ifilot/morseboard-8088/enclosure/morseboard-8088-enclosure.stl

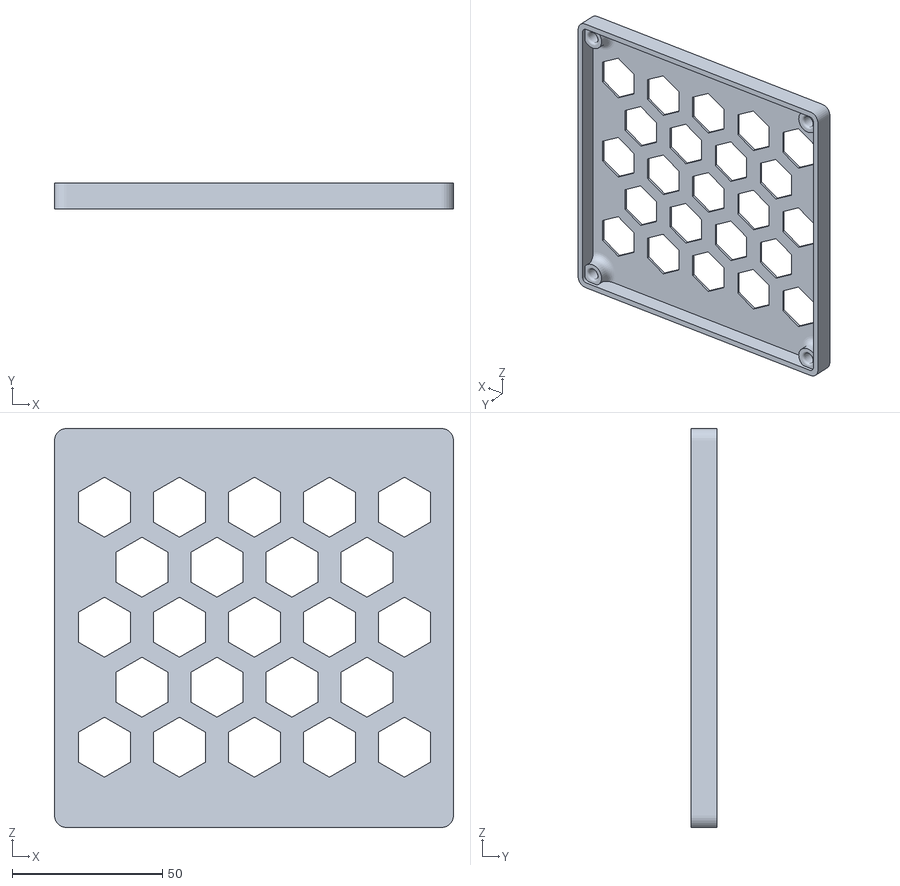
[picture p1: CAD file, 2025-07-02]
enclosure/morseboard-8088-enclosure.stl
133.0 x 8.51 x 133.0
