ifilot/morseboard-8088/pcb/components/USB type-B female PCB.STEP

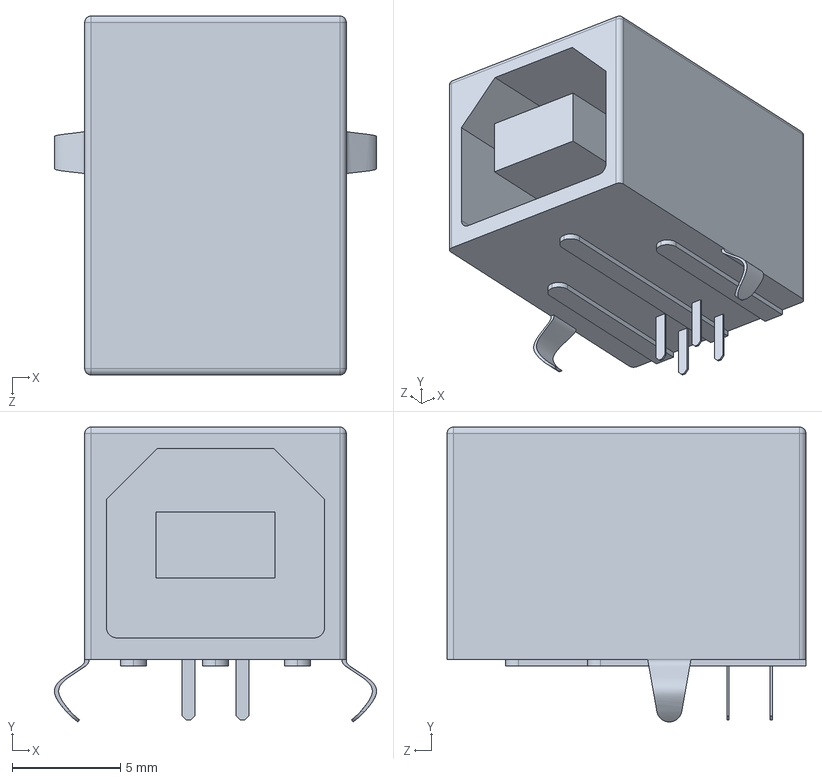
[picture p2: CAD file, 2025-07-06]
pcb/components/USB type-B female PCB.STEP
14.9 x 13.6 x 16.6 mm
