ifilot/morseboard-8088/pcb/components/PLCC44.STEP

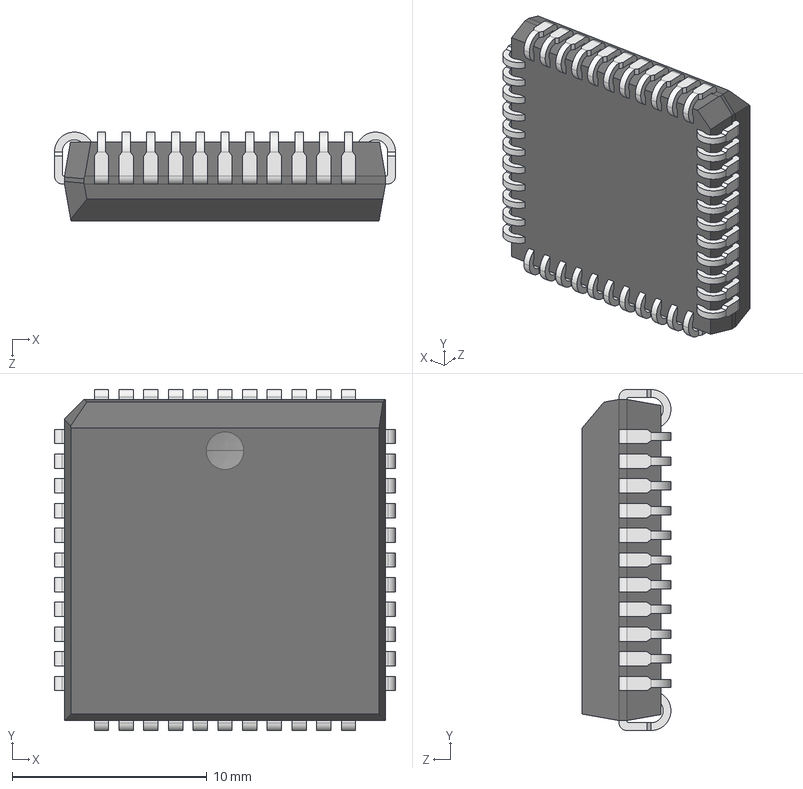
[picture p3: CAD file, 2025-07-06]
pcb/components/PLCC44.STEP
17.5 x 17.5 x 4.57 mm
