ifilot/morseboard-8088/pcb/components/PLCC44_socket.stp

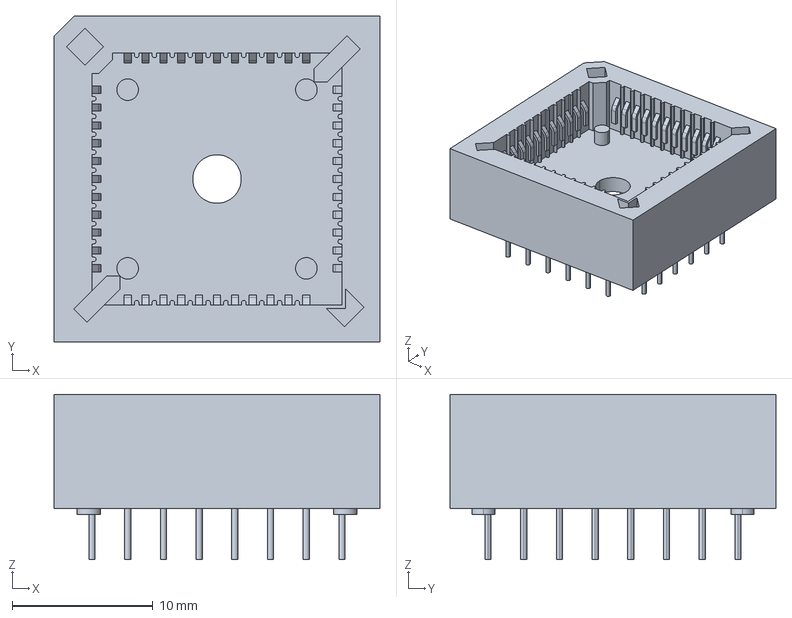
[picture p4: CAD file, 2025-07-06]
pcb/components/PLCC44_socket.stp
23.2 x 23.2 x 11.8 mm
