ifilot/morseboard-8088/pcb/components/switch.stp

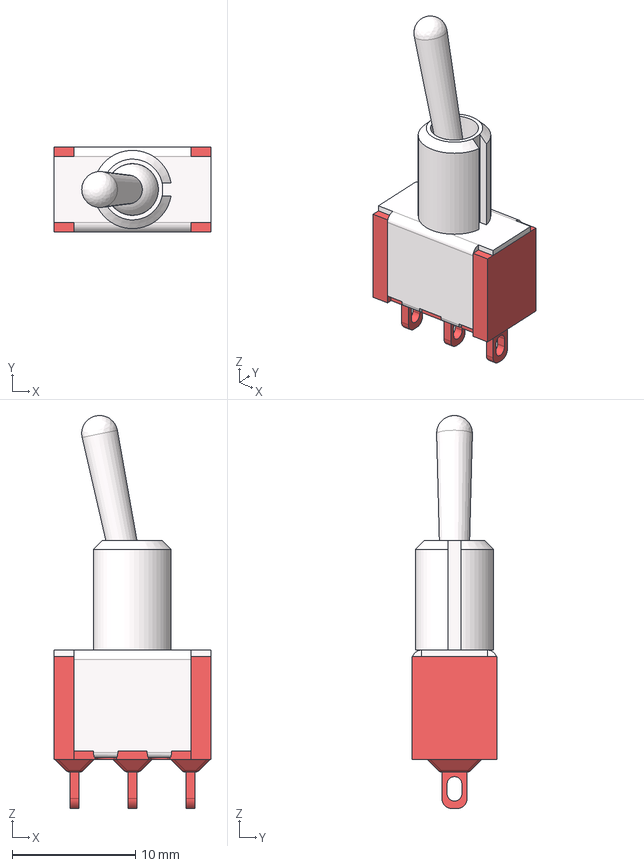
[picture p5: CAD file, 2025-07-06]
pcb/components/switch.stp
12.7 x 6.86 x 31.9 mm
100-300SPXBODY
100SPXBRACKET
100T1
100B1BUSHING
100-300SPXM1
