ifilot/morseboard-8088/(list of files, drawings)

Other design files:
pcb/cpu-testboard/mb88-testboard.dsn
pcb/morseboard-8088/morseboard-8088.dsn
