ifilot/morseboard-8088/pcb/morseboard-8088/morseboard-8088.kicad_pcb

## KiCad design pcb/morseboard-8088/morseboard-8088.kicad_pcb (2025-07-06)

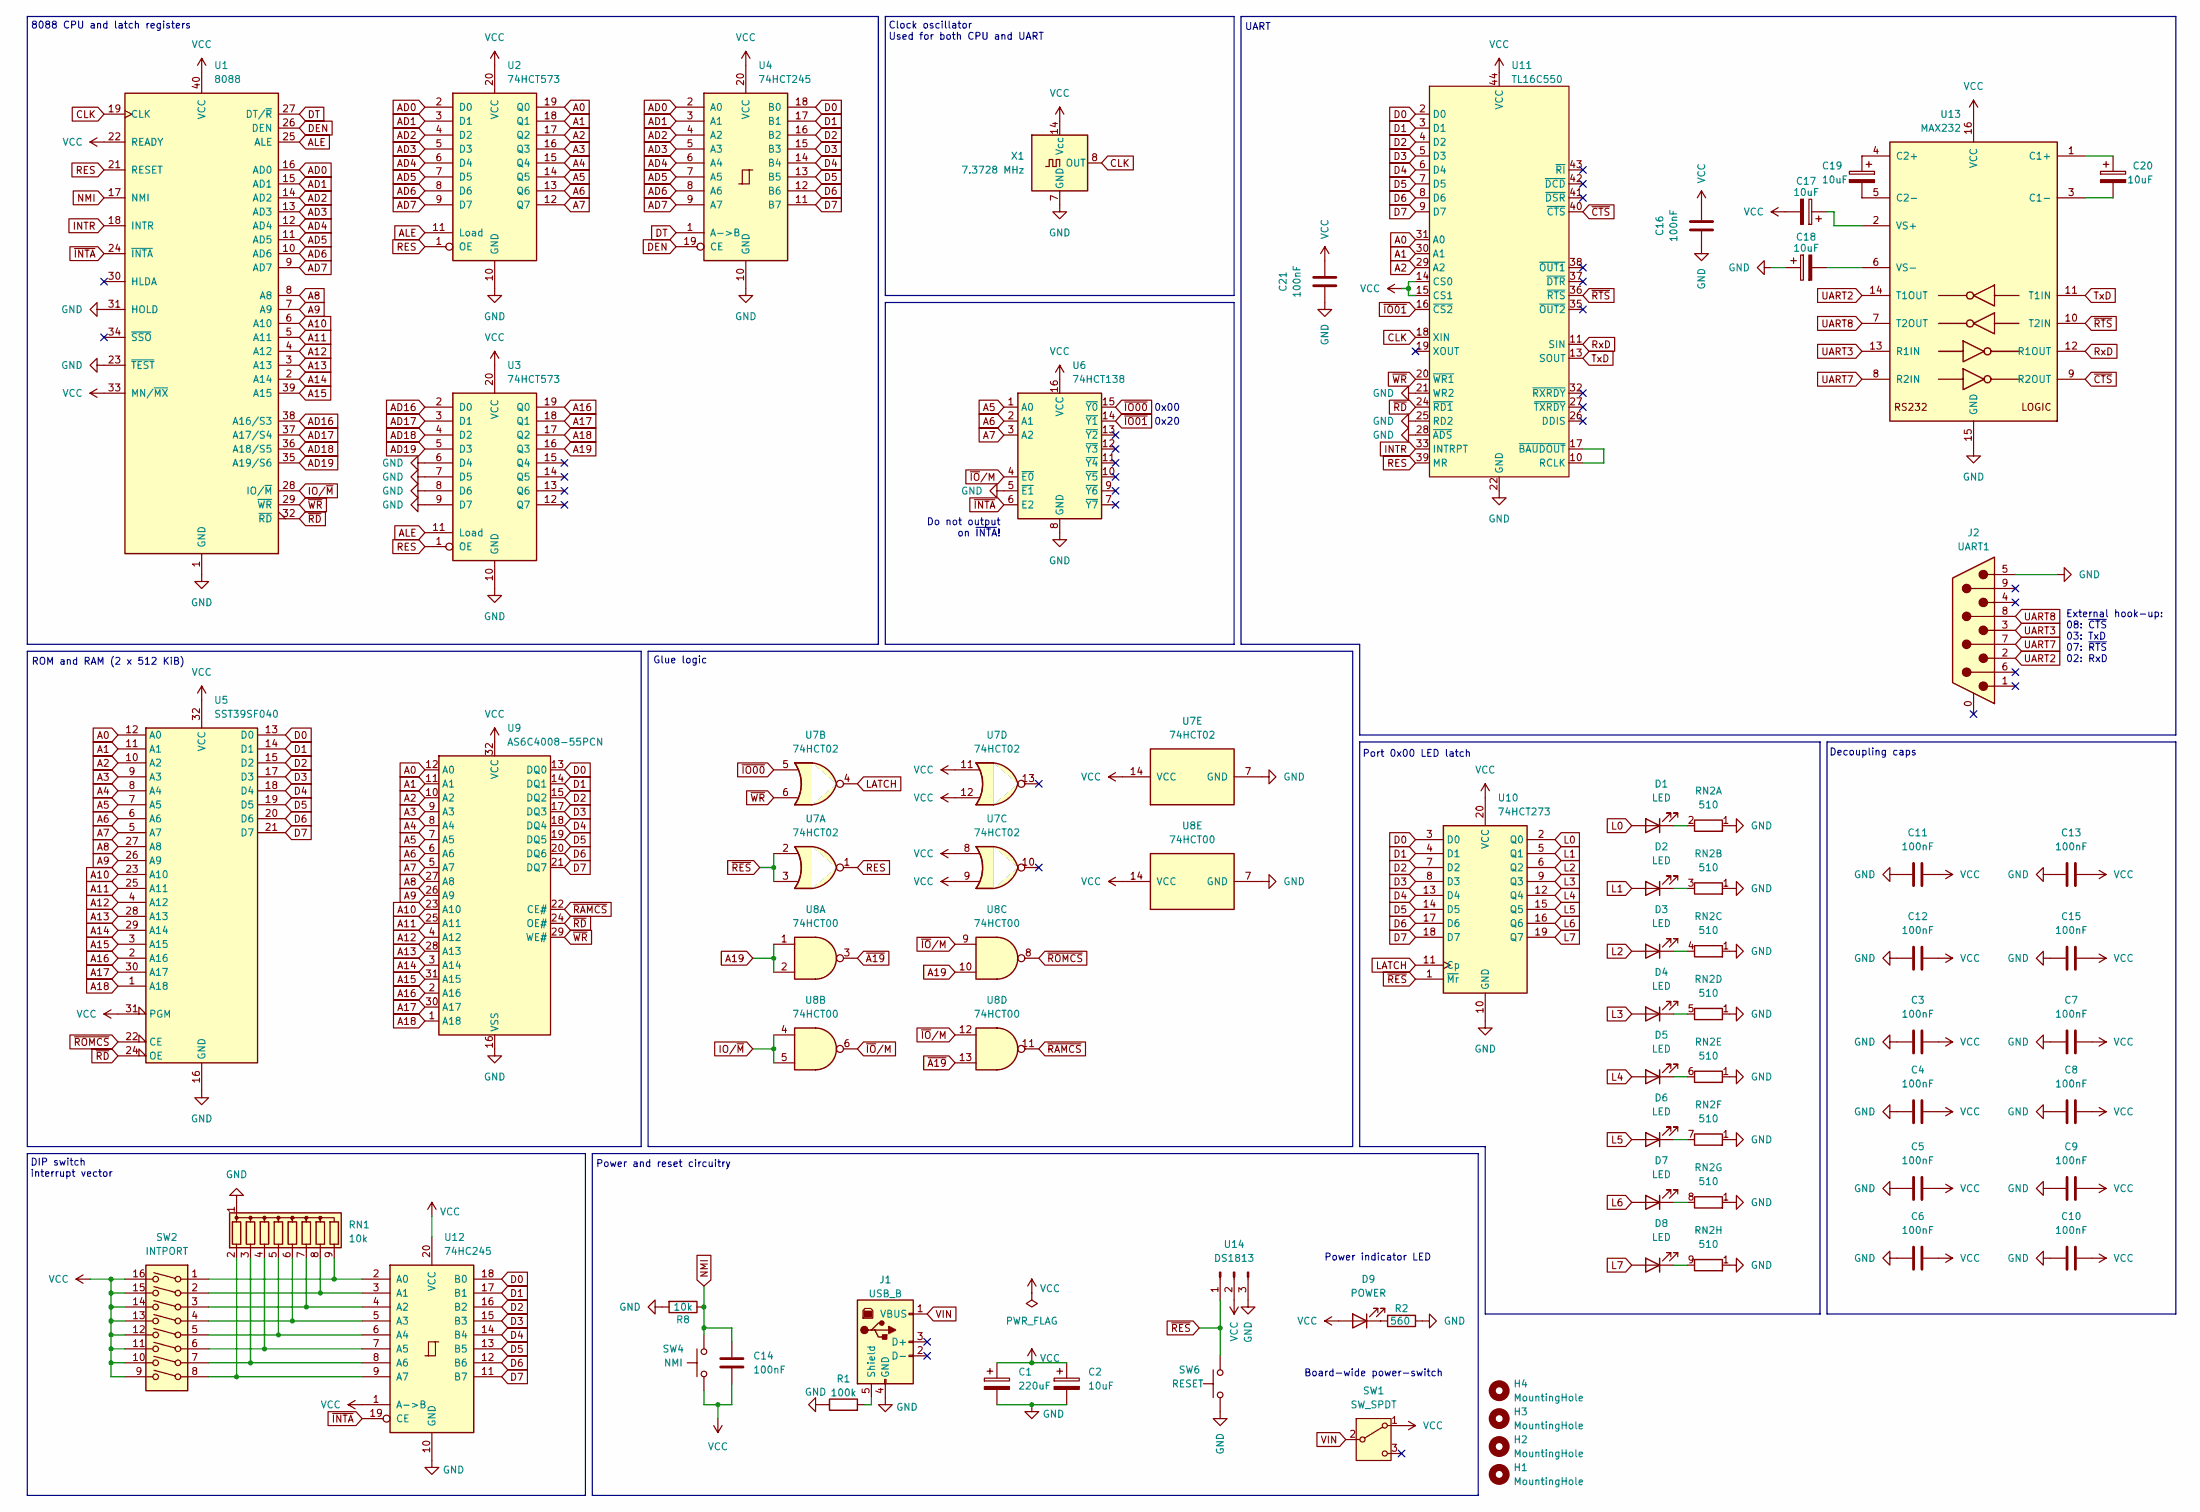
[picture p6: schematic morseboard-8088.kicad_sch]

Parts:
C1: 220uF; CP_Radial_D6.3mm_P2.50mm
C2, C17, C18, C19, C20: 10uF; CP_Radial_D5.0mm_P2.50mm
C3, C4, C5, C6, C7, C8, C9, C10, C11, C12, C13, C14, C15, C16, C21: 100nF; C_Disc_D5.0mm_W2.5mm_P5.00mm
D1, D2, D3, D4, D5, D6, D7, D8: LED; LED_D5.0mm
D9: POWER; LED_D5.0mm
H1, H2, H3, H4: MountingHole; MountingHole_3.2mm_M3_DIN965
J1: USB_B; USB_B_OST_USB-B1HSxx_Horizontal
J2: UART1; DSUB-9_Pins_Horizontal_P2.77x2.84mm_EdgePinOffset4.94mm_Hou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
R1: 100k; R_Axial_DIN0207_L6.3mm_D2.5mm_P7.62mm_Horizontal
R2: 560; R_Axial_DIN0207_L6.3mm_D2.5mm_P7.62mm_Horizontal
R8: 10k; R_Axial_DIN0207_L6.3mm_D2.5mm_P7.62mm_Horizontal
RN1: 10k; R_Array_SIP9
RN2: 510; R_Array_SIP9
SW1: SW_SPDT; power_switch
SW2: INTPORT; SW_DIP_SPSTx08_Slide_9.78x22.5mm_W7.62mm_P2.54mm
SW4: NMI; SW_PUSH_6mm
SW6: RESET; SW_PUSH_6mm
U1: 8088; DIP-40_W15.24mm_Socket
U2, U3: 74HCT573; DIP-20_W7.62mm_Socket
U4: 74HCT245; DIP-20_W7.62mm_Socket
U5: SST39SF040; DIP_Socket-32_W11.9_W12.7_W15.24_W17.78_W18.5_3M_232-1285-0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
U6: 74HCT138; DIP-16_W7.62mm_Socket
U7: 74HCT02; DIP-14_W7.62mm_Socket
U8: 74HCT00; DIP-14_W7.62mm_Socket
U9: AS6C4008-55PCN; DIP-32_W15.24mm_Socket
U10: 74HCT273; DIP-20_W7.62mm_Socket
U11: TL16C550; PLCC-44_THT-Socket
U12: 74HC245; DIP-20_W7.62mm_Socket
U13: MAX232; DIP-16_W7.62mm_Socket
U14: DS1813; TO-92
X1: 7.3728 MHz; Oscillator_DIP-14

Connections:
A0: U2.19 (Q0), U5.12 (A0), U9.12 (A0), U11.31 (A0)
A1: U2.18 (Q1), U5.11 (A1), U9.11 (A1), U11.30 (A1)
A2: U2.17 (Q2), U5.10 (A2), U9.10 (A2), U11.29 (A2)
A3: U2.16 (Q3), U5.9 (A3), U9.9 (A3)
A4: U2.15 (Q4), U5.8 (A4), U9.8 (A4)
A5: U2.14 (Q5), U5.7 (A5), U6.1 (A0), U9.7 (A5)
A6: U2.13 (Q6), U5.6 (A6), U6.2 (A1), U9.6 (A6)
A7: U2.12 (Q7), U5.5 (A7), U6.3 (A2), U9.5 (A7)
A8: U1.8 (A8), U5.27 (A8), U9.27 (A8)
A9: U1.7 (A9), U5.26 (A9), U9.26 (A9)
A10: U1.6 (A10), U5.23 (A10), U9.23 (A10)
A11: U1.5 (A11), U5.25 (A11), U9.25 (A11)
A12: U1.4 (A12), U5.4 (A12), U9.4 (A12)
A13: U1.3 (A13), U5.28 (A13), U9.28 (A13)
A14: U1.2 (A14), U5.29 (A14), U9.3 (A14)
A15: U1.39 (A15), U5.3 (A15), U9.31 (A15)
A16: U3.19 (Q0), U5.2 (A16), U9.2 (A16)
A17: U3.18 (Q1), U5.30 (A17), U9.30 (A17)
A18: U3.17 (Q2), U5.1 (A18), U9.1 (A18)
A19: U3.16 (Q3), U8.1, U8.2, U8.10
AD0: U1.16 (AD0), U2.2 (D0), U4.2 (A0)
AD1: U1.15 (AD1), U2.3 (D1), U4.3 (A1)
AD2: U1.14 (AD2), U2.4 (D2), U4.4 (A2)
AD3: U1.13 (AD3), U2.5 (D3), U4.5 (A3)
AD4: U1.12 (AD4), U2.6 (D4), U4.6 (A4)
AD5: U1.11 (AD5), U2.7 (D5), U4.7 (A5)
AD6: U1.10 (AD6), U2.8 (D6), U4.8 (A6)
AD7: U1.9 (AD7), U2.9 (D7), U4.9 (A7)
AD16: U1.38 (A16/S3), U3.2 (D0)
AD17: U1.37 (A17/S4), U3.3 (D1)
AD18: U1.36 (A18/S5), U3.4 (D2)
AD19: U1.35 (A19/S6), U3.5 (D3)
ALE: U1.25 (ALE), U2.11 (Load), U3.11 (Load)
CLK: U1.19 (CLK), U11.18 (XIN), X1.8 (OUT)
D0: U4.18 (B0), U5.13 (D0), U9.13 (DQ0), U10.3 (D0), U11.2 (D0), U12.18 (B0)
D1: U4.17 (B1), U5.14 (D1), U9.14 (DQ1), U10.4 (D1), U11.3 (D1), U12.17 (B1)
D2: U4.16 (B2), U5.15 (D2), U9.15 (DQ2), U10.7 (D2), U11.4 (D2), U12.16 (B2)
D3: U4.15 (B3), U5.17 (D3), U9.17 (DQ3), U10.8 (D3), U11.5 (D3), U12.15 (B3)
D4: U4.14 (B4), U5.18 (D4), U9.18 (DQ4), U10.13 (D4), U11.6 (D4), U12.14 (B4)
D5: U4.13 (B5), U5.19 (D5), U9.19 (DQ5), U10.14 (D5), U11.7 (D5), U12.13 (B5)
D6: U4.12 (B6), U5.20 (D6), U9.20 (DQ6), U10.17 (D6), U11.8 (D6), U12.12 (B6)
D7: U4.11 (B7), U5.21 (D7), U9.21 (DQ7), U10.18 (D7), U11.9 (D7), U12.11 (B7)
DEN: U1.26 (DEN), U4.19 (CE)
DT: U1.27 (DT/~R), U4.1 (A->B)
GND: C1.2, C2.2, C3.2, C4.2, C5.2, C6.2, C7.2, C8.2, C9.2, C10.2, C11.2, C12.2, C13.2, C15.2, C16.2, C18.1, C21.2, J1.4 (GND), J2.5, R1.1, R2.1, R8.2, RN1.1 (common), RN2.1 (R1), SW6.1, U1.1 (GND), U1.20 (GND), U1.23 (~TEST), U1.31 (HOLD), U2.10 (GND), U3.6 (D4), U3.7 (D5), U3.8 (D6), U3.9 (D7), U3.10 (GND), U4.10 (GND), U5.16 (GND), U6.5 (~E1), U6.8 (GND), U7.7 (GND), U8.7 (GND), U9.16 (VSS), U10.10 (GND), U11.21 (WR2), U11.22 (GND), U11.25 (RD2), U11.28 (~ADS), U12.10 (GND), U13.15 (GND), U14.3, X1.7 (GND)
INTR: U1.18 (INTR), U11.33 (INTRPT)
IO/~M: U1.28 (IO/~M), U8.4, U8.5
L0: D1.2 (A), U10.2 (Q0)
L1: D2.2 (A), U10.5 (Q1)
L2: D3.2 (A), U10.6 (Q2)
L3: D4.2 (A), U10.9 (Q3)
L4: D5.2 (A), U10.12 (Q4)
L5: D6.2 (A), U10.15 (Q5)
L6: D7.2 (A), U10.16 (Q6)
L7: D8.2 (A), U10.19 (Q7)
LATCH: U7.4, U10.11 (Cp)
NMI: C14.1, R8.1, SW4.2, U1.17 (NMI)
unnamed: D1.1 (K), RN2.2 (R1.2)
unnamed: D2.1 (K), RN2.3 (R2.2)
unnamed: D3.1 (K), RN2.4 (R3.2)
unnamed: D4.1 (K), RN2.5 (R4.2)
unnamed: D5.1 (K), RN2.6 (R5.2)
unnamed: D6.1 (K), RN2.7 (R6.2)
unnamed: D7.1 (K), RN2.8 (R7.2)
unnamed: D8.1 (K), RN2.9 (R8.2)
unnamed: D9.1 (K), R2.2
unnamed: J1.5 (Shield), R1.2
unnamed: RN1.2 (R1), SW2.8, U12.9 (A7)
unnamed: RN1.3 (R2), SW2.7, U12.8 (A6)
unnamed: RN1.4 (R3), SW2.6, U12.7 (A5)
unnamed: RN1.5 (R4), SW2.5, U12.6 (A4)
unnamed: RN1.6 (R5), SW2.4, U12.5 (A3)
unnamed: RN1.7 (R6), SW2.3, U12.4 (A2)
unnamed: RN1.8 (R7), SW2.2, U12.3 (A1)
unnamed: RN1.9 (R8), SW2.1, U12.2 (A0)
unnamed: U11.10 (RCLK), U11.17 (~BAUDOUT)
unnamed: C20.1, U13.1 (C1+)
unnamed: C20.2, U13.3 (C1-)
unnamed: C19.1, U13.4 (C2+)
unnamed: C19.2, U13.5 (C2-)
unnamed: C17.1, U13.2 (VS+)
unnamed: C18.2, U13.6 (VS-)
RES: U1.21 (RESET), U2.1 (OE), U3.1 (OE), U7.1, U11.39 (MR)
RxD: U11.11 (SIN), U13.12 (R1OUT)
TxD: U11.13 (SOUT), U13.11 (T1IN)
UART2: J2.2, U13.14 (T1OUT)
UART3: J2.3, U13.13 (R1IN)
UART7: J2.7, U13.8 (R2IN)
UART8: J2.8, U13.7 (T2OUT)
VCC: C1.1, C2.1, C3.1, C4.1, C5.1, C6.1, C7.1, C8.1, C9.1, C10.1, C11.1, C12.1, C13.1, C14.2, C15.1, C16.1, C17.2, C21.1, D9.2 (A), SW1.1 (A), SW2.9, SW2.10, SW2.11, SW2.12, SW2.13, SW2.14, SW2.15, SW2.16, SW4.1, U1.22 (READY), U1.33 (MN/~MX), U1.40 (VCC), U2.20 (VCC), U3.20 (VCC), U4.20 (VCC), U5.31 (PGM), U5.32 (VCC), U6.16 (VCC), U7.8, U7.9, U7.11, U7.12, U7.14 (VCC), U8.14 (VCC), U9.32 (VCC), U10.20 (VCC), U11.14 (CS0), U11.15 (CS1), U11.44 (VCC), U12.1 (A->B), U12.20 (VCC), U13.16 (VCC), U14.2, X1.14 (Vcc)
VIN: J1.1 (VBUS), SW1.2 (B)
~A19: U8.3, U8.13
~CTS: U11.40 (~CTS), U13.9 (R2OUT)
~INTA: U1.24 (~INTA), U6.6 (E2), U12.19 (CE)
~IO00: U6.15 (~Y0), U7.5
~IO01: U6.14 (~Y1), U11.16 (~CS2)
~IO/M: U6.4 (~E0), U8.6, U8.9, U8.12
~RAMCS: U8.11, U9.22 (CE#)
~RD: U1.32 (~RD), U5.24 (OE), U9.24 (OE#), U11.24 (~RD1)
~RES: SW6.2, U7.2, U7.3, U10.1 (~Mr), U14.1
~ROMCS: U5.22 (CE), U8.8
~RTS: U11.36 (~RTS), U13.10 (T2IN)
~WR: U1.29 (~WR), U7.6, U9.29 (WE#), U11.20 (~WR1)

Notes on the sheet:
Decoupling caps
0x20
Port 0x00 LED latch
Board-wide power-switch
8088 CPU and latch registers
Power and reset circuitry
Do not output on ~{INTA}!
UART
Power indicator LED
Glue logic
0x00
ROM and RAM (2 x 512 KiB)
External hook-up: 08: ~{CTS} 03: TxD 07: ~{RTS} 02: RxD
Clock oscillator Used for both CPU and UART
DIP switch interrupt vector

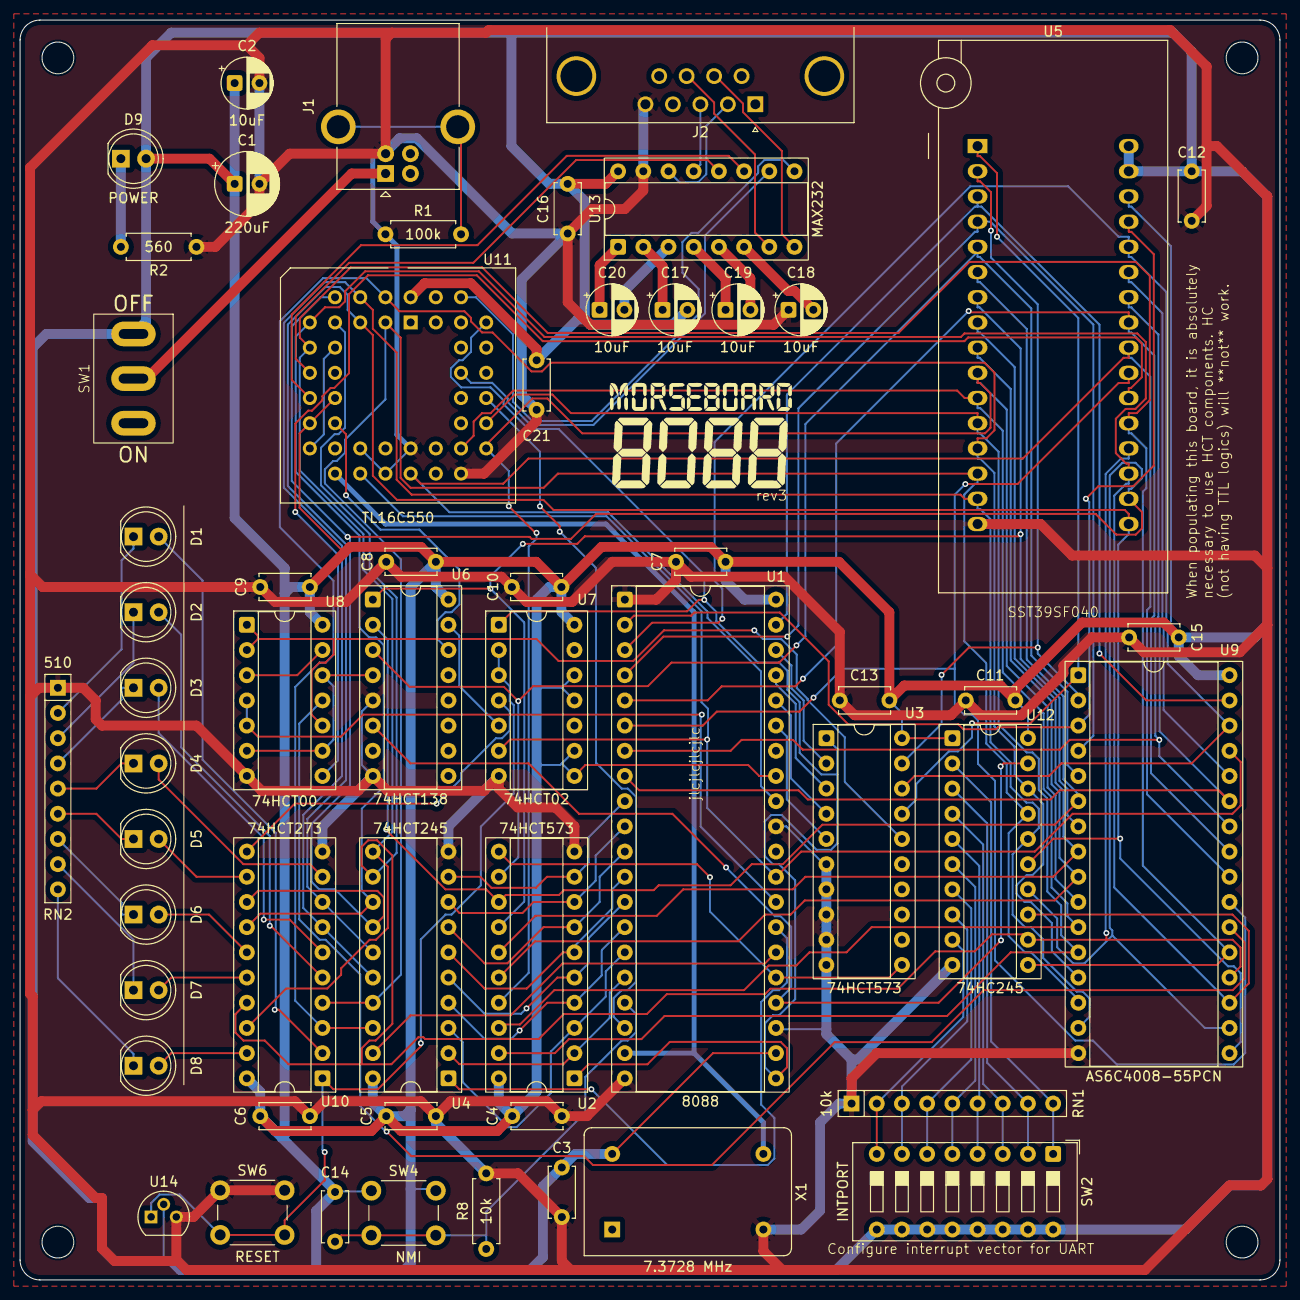
[picture p7: board morseboard-8088.kicad_pcb from above]

Board: 2 copper layers, 127.0 x 127.0 mm, 61 parts (0 on the bottom side), 103 nets.

Other parts of the board:
G001: LOGO; morseboard-logo-12h
