ifilot/morseboard-8088/pcb/cpu-testboard/mb88-testboard.kicad_pcb

## KiCad design pcb/cpu-testboard/mb88-testboard.kicad_pcb (2025-05-21)

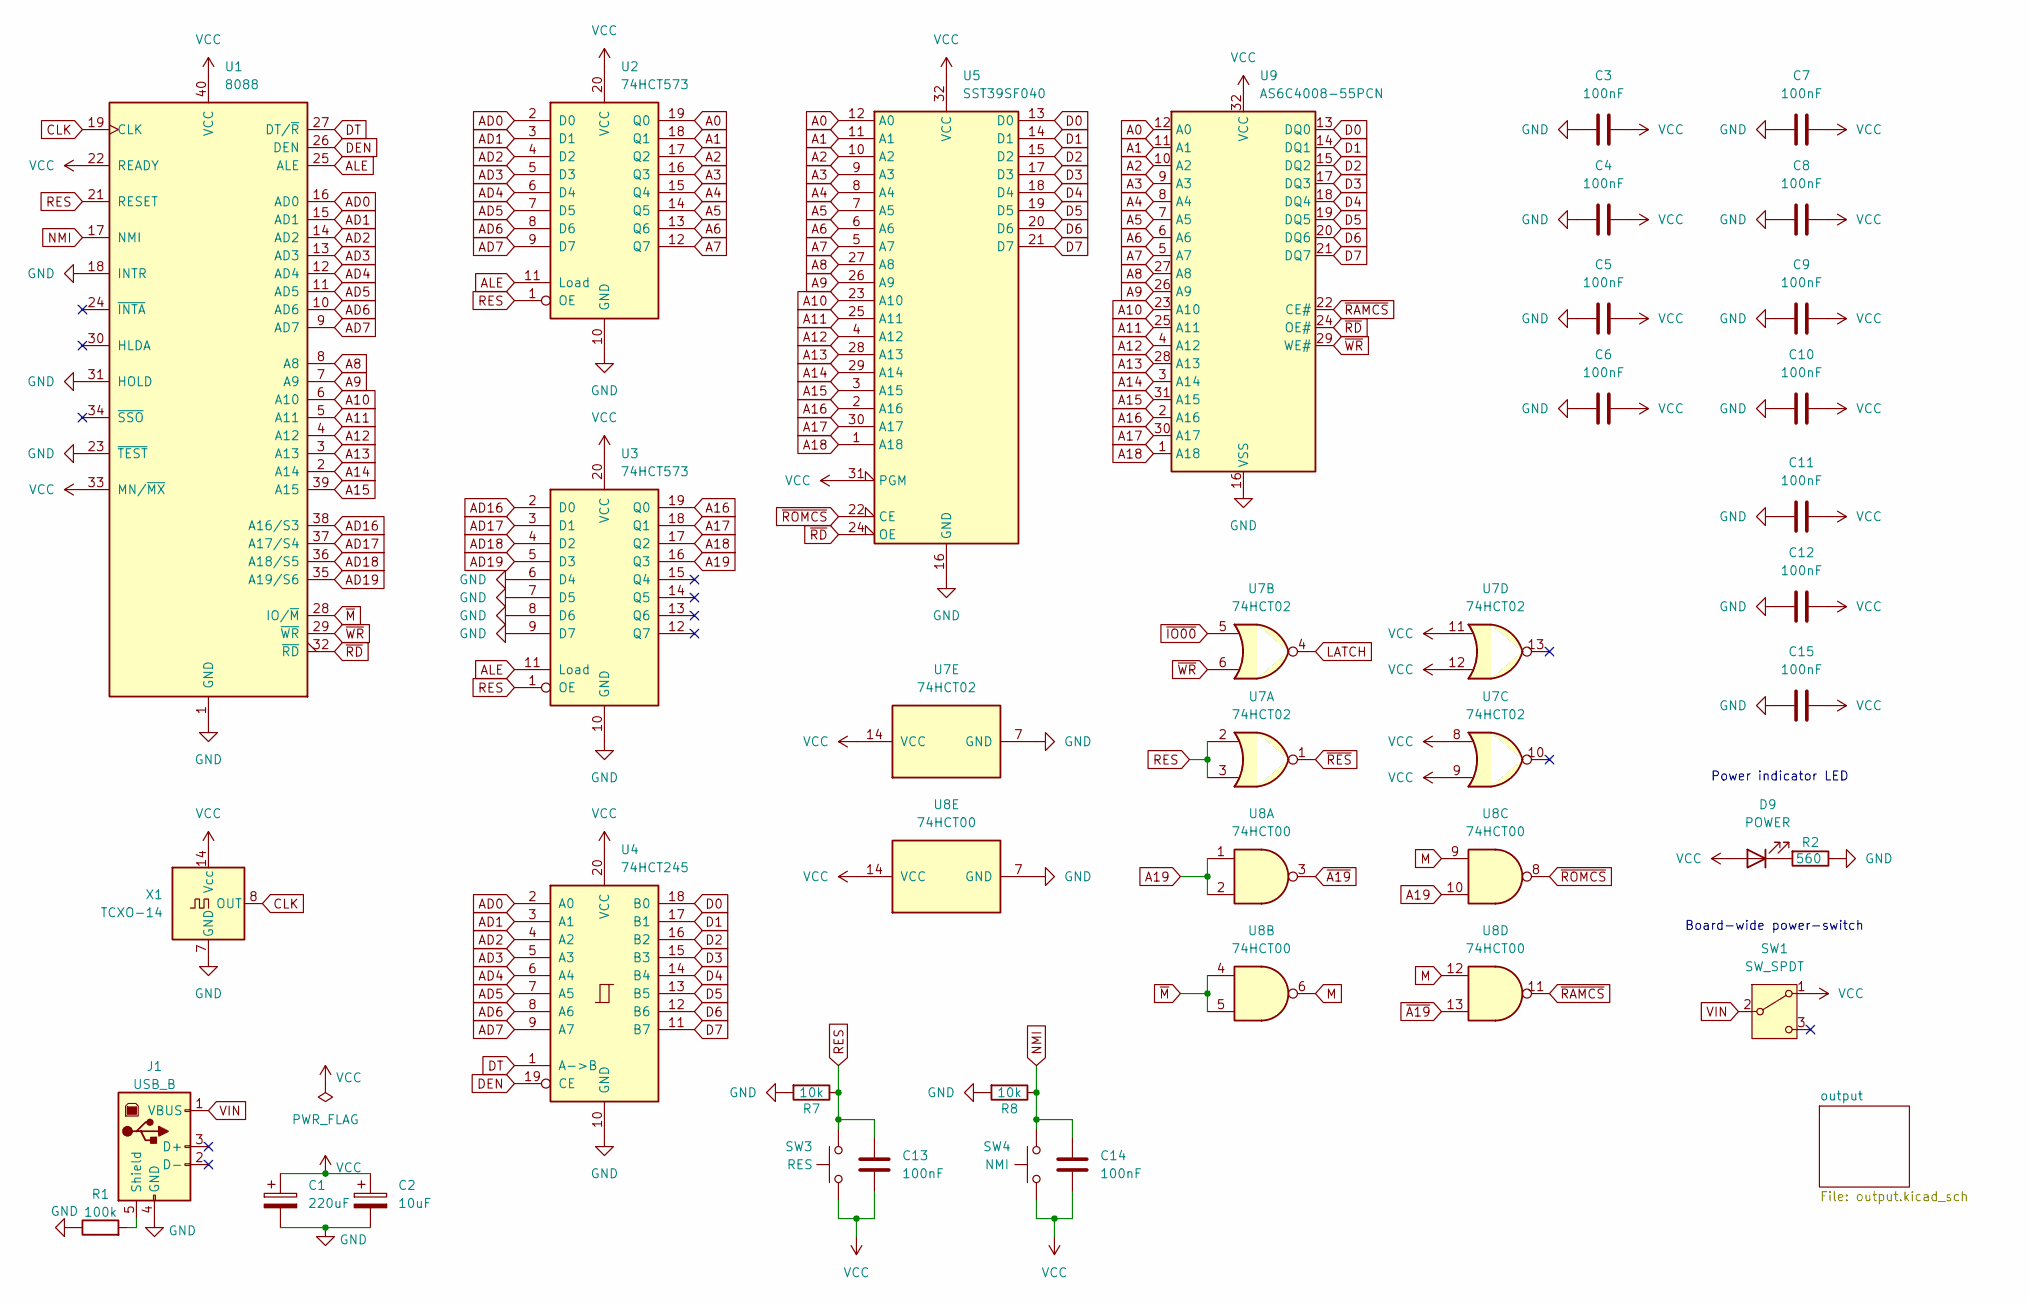
[picture p8: schematic mb88-testboard.kicad_sch, Morse Board 8088 TEST BOARD]

Parts:
C1: 220uF; CP_Radial_D6.3mm_P2.50mm
C2: 10uF; CP_Radial_D5.0mm_P2.50mm
C3, C4, C5, C6, C7, C8, C9, C10, C11, C12, C13, C14, C15: 100nF; C_Disc_D5.0mm_W2.5mm_P5.00mm
D9: POWER; LED_D5.0mm
J1: USB_B; USB_B_OST_USB-B1HSxx_Horizontal
R1: 100k; R_Axial_DIN0207_L6.3mm_D2.5mm_P7.62mm_Horizontal
R2: 560; R_Axial_DIN0207_L6.3mm_D2.5mm_P7.62mm_Horizontal
R7, R8: 10k; R_Axial_DIN0207_L6.3mm_D2.5mm_P7.62mm_Horizontal
SW1: SW_SPDT; power_switch
SW3: RES; SW_PUSH_6mm
SW4: NMI; SW_PUSH_6mm
U1: 8088; DIP-40_W15.24mm_Socket
U2, U3: 74HCT573; DIP-20_W7.62mm_Socket
U4: 74HCT245; DIP-20_W7.62mm_Socket
U5: SST39SF040; DIP_Socket-32_W11.9_W12.7_W15.24_W17.78_W18.5_3M_232-1285-0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
U7: 74HCT02; DIP-14_W7.62mm_Socket
U8: 74HCT00; DIP-14_W7.62mm_Socket
U9: AS6C4008-55PCN; DIP-32_W15.24mm_Socket
X1: TCXO-14; Oscillator_DIP-14

Connections:
A0: U2.19 (Q0), U5.12 (A0), U9.12 (A0); also elsewhere on the board
A1: U2.18 (Q1), U5.11 (A1), U9.11 (A1); also elsewhere on the board
A2: U2.17 (Q2), U5.10 (A2), U9.10 (A2); also elsewhere on the board
A3: U2.16 (Q3), U5.9 (A3), U9.9 (A3); also elsewhere on the board
A4: U2.15 (Q4), U5.8 (A4), U9.8 (A4); also elsewhere on the board
A5: U2.14 (Q5), U5.7 (A5), U9.7 (A5); also elsewhere on the board
A6: U2.13 (Q6), U5.6 (A6), U9.6 (A6); also elsewhere on the board
A7: U2.12 (Q7), U5.5 (A7), U9.5 (A7); also elsewhere on the board
A8: U1.8 (A8), U5.27 (A8), U9.27 (A8); also elsewhere on the board
A9: U1.7 (A9), U5.26 (A9), U9.26 (A9); also elsewhere on the board
A10: U1.6 (A10), U5.23 (A10), U9.23 (A10); also elsewhere on the board
A11: U1.5 (A11), U5.25 (A11), U9.25 (A11); also elsewhere on the board
A12: U1.4 (A12), U5.4 (A12), U9.4 (A12); also elsewhere on the board
A13: U1.3 (A13), U5.28 (A13), U9.28 (A13); also elsewhere on the board
A14: U1.2 (A14), U5.29 (A14), U9.3 (A14); also elsewhere on the board
A15: U1.39 (A15), U5.3 (A15), U9.31 (A15); also elsewhere on the board
A16: U3.19 (Q0), U5.2 (A16), U9.2 (A16); also elsewhere on the board
A17: U3.18 (Q1), U5.30 (A17), U9.30 (A17); also elsewhere on the board
A18: U3.17 (Q2), U5.1 (A18), U9.1 (A18); also elsewhere on the board
A19: U3.16 (Q3), U8.1, U8.2, U8.10; also elsewhere on the board
AD0: U1.16 (AD0), U2.2 (D0), U4.2 (A0)
AD1: U1.15 (AD1), U2.3 (D1), U4.3 (A1)
AD2: U1.14 (AD2), U2.4 (D2), U4.4 (A2)
AD3: U1.13 (AD3), U2.5 (D3), U4.5 (A3)
AD4: U1.12 (AD4), U2.6 (D4), U4.6 (A4)
AD5: U1.11 (AD5), U2.7 (D5), U4.7 (A5)
AD6: U1.10 (AD6), U2.8 (D6), U4.8 (A6)
AD7: U1.9 (AD7), U2.9 (D7), U4.9 (A7)
AD16: U1.38 (A16/S3), U3.2 (D0)
AD17: U1.37 (A17/S4), U3.3 (D1)
AD18: U1.36 (A18/S5), U3.4 (D2)
AD19: U1.35 (A19/S6), U3.5 (D3)
ALE: U1.25 (ALE), U2.11 (Load), U3.11 (Load)
CLK: U1.19 (CLK), X1.8 (OUT); also elsewhere on the board
D0: U4.18 (B0), U5.13 (D0), U9.13 (DQ0); also elsewhere on the board
D1: U4.17 (B1), U5.14 (D1), U9.14 (DQ1); also elsewhere on the board
D2: U4.16 (B2), U5.15 (D2), U9.15 (DQ2); also elsewhere on the board
D3: U4.15 (B3), U5.17 (D3), U9.17 (DQ3); also elsewhere on the board
D4: U4.14 (B4), U5.18 (D4), U9.18 (DQ4); also elsewhere on the board
D5: U4.13 (B5), U5.19 (D5), U9.19 (DQ5); also elsewhere on the board
D6: U4.12 (B6), U5.20 (D6), U9.20 (DQ6); also elsewhere on the board
D7: U4.11 (B7), U5.21 (D7), U9.21 (DQ7); also elsewhere on the board
DEN: U1.26 (DEN), U4.19 (CE); also elsewhere on the board
DT: U1.27 (DT/~R), U4.1 (A->B)
GND: C1.2, C2.2, C3.2, C4.2, C5.2, C6.2, C7.2, C8.2, C9.2, C10.2, C11.2, C12.2, C15.2, J1.4 (GND), R1.1, R2.1, R7.2, R8.2, U1.1 (GND), U1.18 (INTR), U1.20 (GND), U1.23 (~TEST), U1.31 (HOLD), U2.10 (GND), U3.6 (D4), U3.7 (D5), U3.8 (D6), U3.9 (D7), U3.10 (GND), U4.10 (GND), U5.16 (GND), U7.7 (GND), U8.7 (GND), U9.16 (VSS), X1.7 (GND); also elsewhere on the board
LATCH: U7.4; also elsewhere on the board
M: U8.6, U8.9, U8.12
NMI: C14.1, R8.1, SW4.2, U1.17 (NMI)
unnamed: D9.1 (K), R2.2
unnamed: J1.5 (Shield), R1.2
RES: C13.1, R7.1, SW3.2, U1.21 (RESET), U2.1 (OE), U3.1 (OE), U7.2, U7.3; also elsewhere on the board
VCC: C1.1, C2.1, C3.1, C4.1, C5.1, C6.1, C7.1, C8.1, C9.1, C10.1, C11.1, C12.1, C13.2, C14.2, C15.1, D9.2 (A), SW1.1 (A), SW3.1, SW4.1, U1.22 (READY), U1.33 (MN/~MX), U1.40 (VCC), U2.20 (VCC), U3.20 (VCC), U4.20 (VCC), U5.31 (PGM), U5.32 (VCC), U7.8, U7.9, U7.11, U7.12, U7.14 (VCC), U8.14 (VCC), U9.32 (VCC), X1.14 (Vcc); also elsewhere on the board
VIN: J1.1 (VBUS), SW1.2 (B)
~A19: U8.3, U8.13
~IO00: U7.5; also elsewhere on the board
~M: U1.28 (IO/~M), U8.4, U8.5; also elsewhere on the board
~RAMCS: U8.11, U9.22 (CE#)
~RD: U1.32 (~RD), U5.24 (OE), U9.24 (OE#)
~RES: U7.1; also elsewhere on the board
~ROMCS: U5.22 (CE), U8.8
~WR: U1.29 (~WR), U7.6, U9.29 (WE#)

Notes on the sheet:
Board-wide power-switch
Power indicator LED

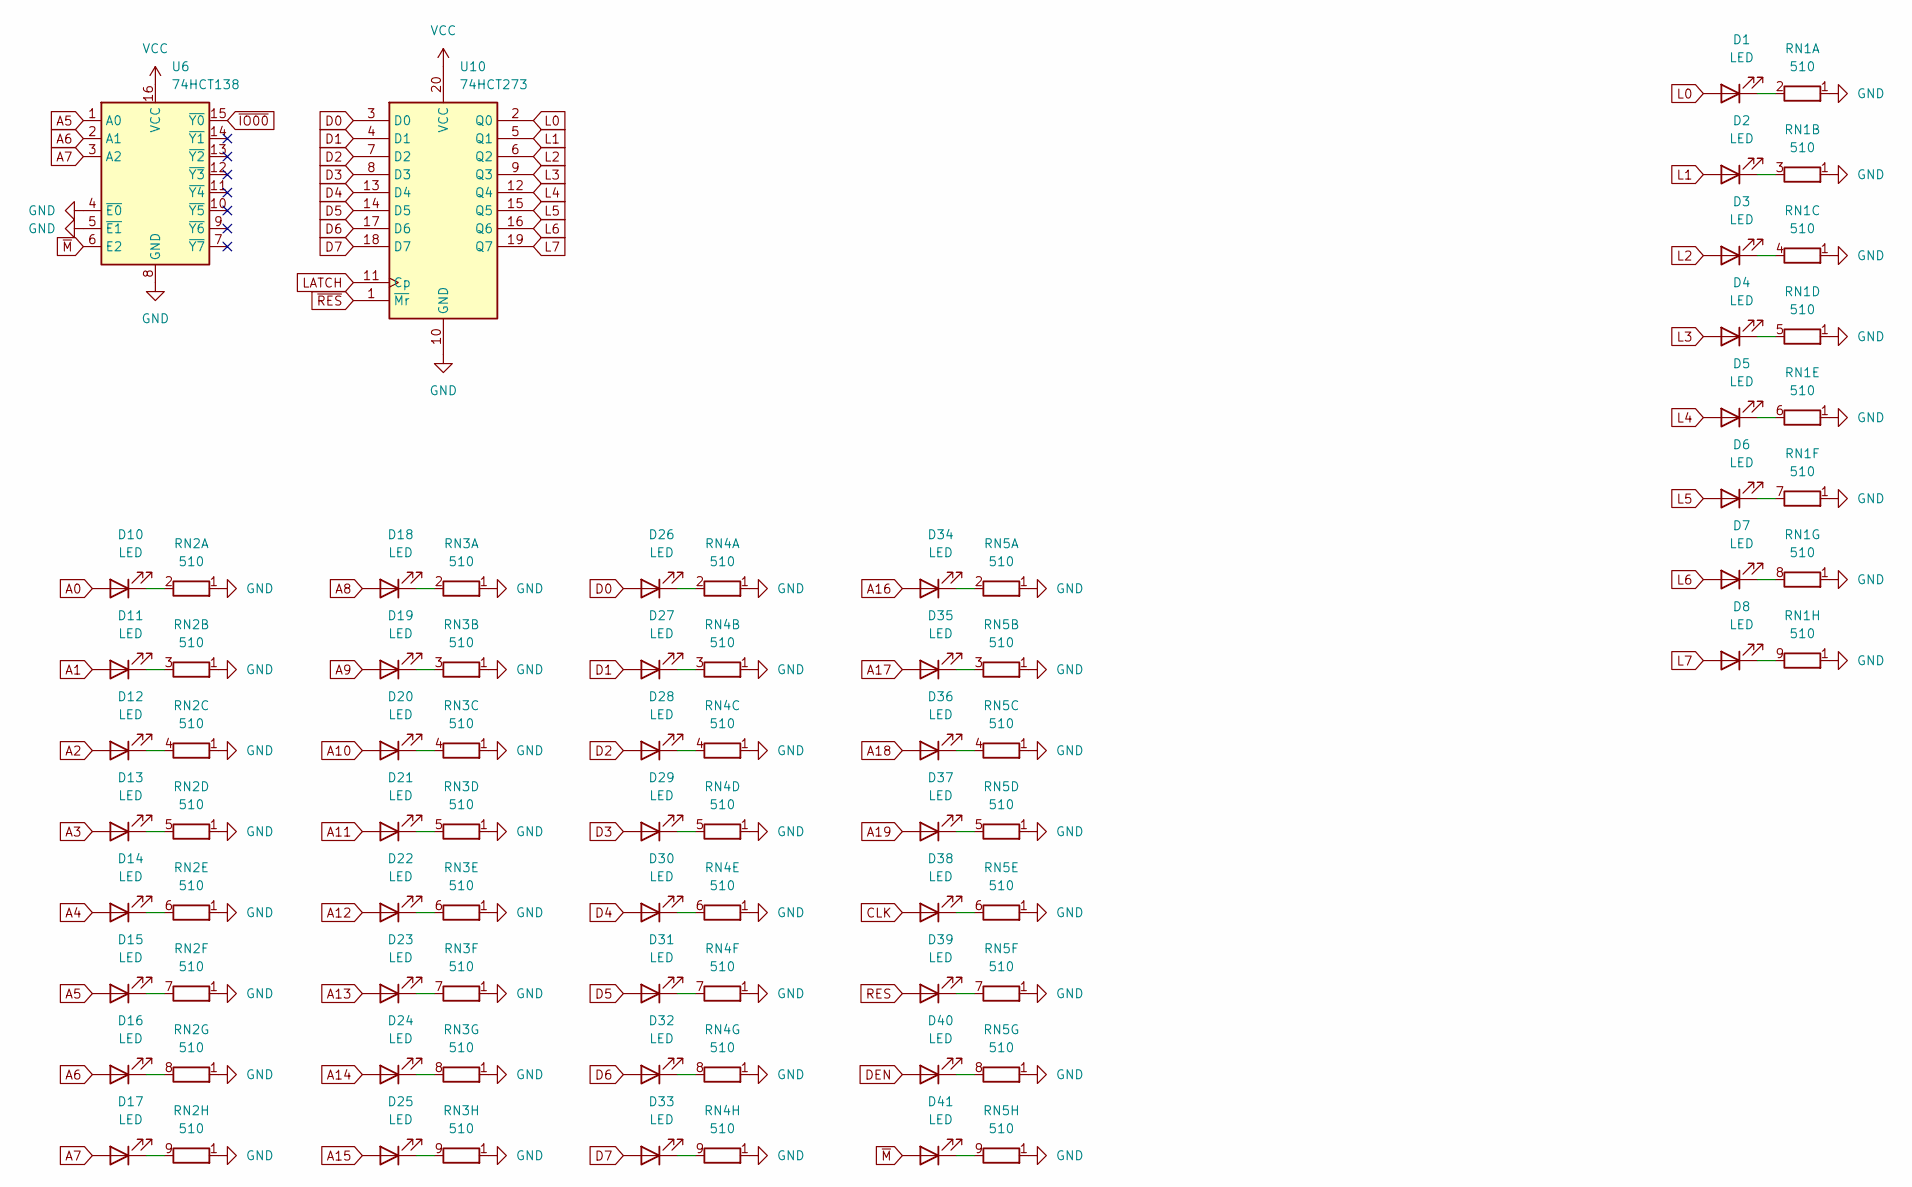
[picture p9: schematic output.kicad_sch, Morse Board 8088 TEST BOARD]

Parts:
D1, D2, D3, D4, D5, D6, D7, D8, D10, D11, D12, D13, D14, D15, D16, D17, D18, D19, D20, D21, D22, D23, D24, D25, D26, D27, D28, D29, D30, D31, D32, D33, D34, D35, D36, D37, D38, D39, D40, D41: LED; LED_D5.0mm
RN1, RN2, RN3, RN4, RN5: 510; R_Array_SIP9
U6: 74HCT138; DIP-16_W7.62mm_Socket
U10: 74HCT273; DIP-20_W7.62mm_Socket

Connections:
A0: D10.2 (A); also elsewhere on the board
A1: D11.2 (A); also elsewhere on the board
A2: D12.2 (A); also elsewhere on the board
A3: D13.2 (A); also elsewhere on the board
A4: D14.2 (A); also elsewhere on the board
A5: D15.2 (A), U6.1 (A0); also elsewhere on the board
A6: D16.2 (A), U6.2 (A1); also elsewhere on the board
A7: D17.2 (A), U6.3 (A2); also elsewhere on the board
A8: D18.2 (A); also elsewhere on the board
A9: D19.2 (A); also elsewhere on the board
A10: D20.2 (A); also elsewhere on the board
A11: D21.2 (A); also elsewhere on the board
A12: D22.2 (A); also elsewhere on the board
A13: D23.2 (A); also elsewhere on the board
A14: D24.2 (A); also elsewhere on the board
A15: D25.2 (A); also elsewhere on the board
A16: D34.2 (A); also elsewhere on the board
A17: D35.2 (A); also elsewhere on the board
A18: D36.2 (A); also elsewhere on the board
A19: D37.2 (A); also elsewhere on the board
CLK: D38.2 (A); also elsewhere on the board
D0: D26.2 (A), U10.3 (D0); also elsewhere on the board
D1: D27.2 (A), U10.4 (D1); also elsewhere on the board
D2: D28.2 (A), U10.7 (D2); also elsewhere on the board
D3: D29.2 (A), U10.8 (D3); also elsewhere on the board
D4: D30.2 (A), U10.13 (D4); also elsewhere on the board
D5: D31.2 (A), U10.14 (D5); also elsewhere on the board
D6: D32.2 (A), U10.17 (D6); also elsewhere on the board
D7: D33.2 (A), U10.18 (D7); also elsewhere on the board
DEN: D40.2 (A); also elsewhere on the board
GND: RN1.1 (R1), RN2.1 (R1), RN3.1 (R1), RN4.1 (R1), RN5.1 (R1), U6.4 (~E0), U6.5 (~E1), U6.8 (GND), U10.10 (GND); also elsewhere on the board
L0: D1.2 (A), U10.2 (Q0)
L1: D2.2 (A), U10.5 (Q1)
L2: D3.2 (A), U10.6 (Q2)
L3: D4.2 (A), U10.9 (Q3)
L4: D5.2 (A), U10.12 (Q4)
L5: D6.2 (A), U10.15 (Q5)
L6: D7.2 (A), U10.16 (Q6)
L7: D8.2 (A), U10.19 (Q7)
LATCH: U10.11 (Cp); also elsewhere on the board
unnamed: D1.1 (K), RN1.2 (R1.2)
unnamed: D2.1 (K), RN1.3 (R2.2)
unnamed: D3.1 (K), RN1.4 (R3.2)
unnamed: D4.1 (K), RN1.5 (R4.2)
unnamed: D5.1 (K), RN1.6 (R5.2)
unnamed: D6.1 (K), RN1.7 (R6.2)
unnamed: D7.1 (K), RN1.8 (R7.2)
unnamed: D8.1 (K), RN1.9 (R8.2)
unnamed: D10.1 (K), RN2.2 (R1.2)
unnamed: D11.1 (K), RN2.3 (R2.2)
unnamed: D12.1 (K), RN2.4 (R3.2)
unnamed: D13.1 (K), RN2.5 (R4.2)
unnamed: D14.1 (K), RN2.6 (R5.2)
unnamed: D15.1 (K), RN2.7 (R6.2)
unnamed: D16.1 (K), RN2.8 (R7.2)
unnamed: D17.1 (K), RN2.9 (R8.2)
unnamed: D18.1 (K), RN3.2 (R1.2)
unnamed: D19.1 (K), RN3.3 (R2.2)
unnamed: D20.1 (K), RN3.4 (R3.2)
unnamed: D21.1 (K), RN3.5 (R4.2)
unnamed: D22.1 (K), RN3.6 (R5.2)
unnamed: D23.1 (K), RN3.7 (R6.2)
unnamed: D24.1 (K), RN3.8 (R7.2)
unnamed: D25.1 (K), RN3.9 (R8.2)
unnamed: D26.1 (K), RN4.2 (R1.2)
unnamed: D27.1 (K), RN4.3 (R2.2)
unnamed: D28.1 (K), RN4.4 (R3.2)
unnamed: D29.1 (K), RN4.5 (R4.2)
unnamed: D30.1 (K), RN4.6 (R5.2)
unnamed: D31.1 (K), RN4.7 (R6.2)
unnamed: D32.1 (K), RN4.8 (R7.2)
unnamed: D33.1 (K), RN4.9 (R8.2)
unnamed: D34.1 (K), RN5.2 (R1.2)
unnamed: D35.1 (K), RN5.3 (R2.2)
unnamed: D36.1 (K), RN5.4 (R3.2)
unnamed: D37.1 (K), RN5.5 (R4.2)
unnamed: D38.1 (K), RN5.6 (R5.2)
unnamed: D39.1 (K), RN5.7 (R6.2)
unnamed: D40.1 (K), RN5.8 (R7.2)
unnamed: D41.1 (K), RN5.9 (R8.2)
RES: D39.2 (A); also elsewhere on the board
VCC: U6.16 (VCC), U10.20 (VCC); also elsewhere on the board
~IO00: U6.15 (~Y0); also elsewhere on the board
~M: D41.2 (A), U6.6 (E2); also elsewhere on the board
~RES: U10.1 (~Mr); also elsewhere on the board

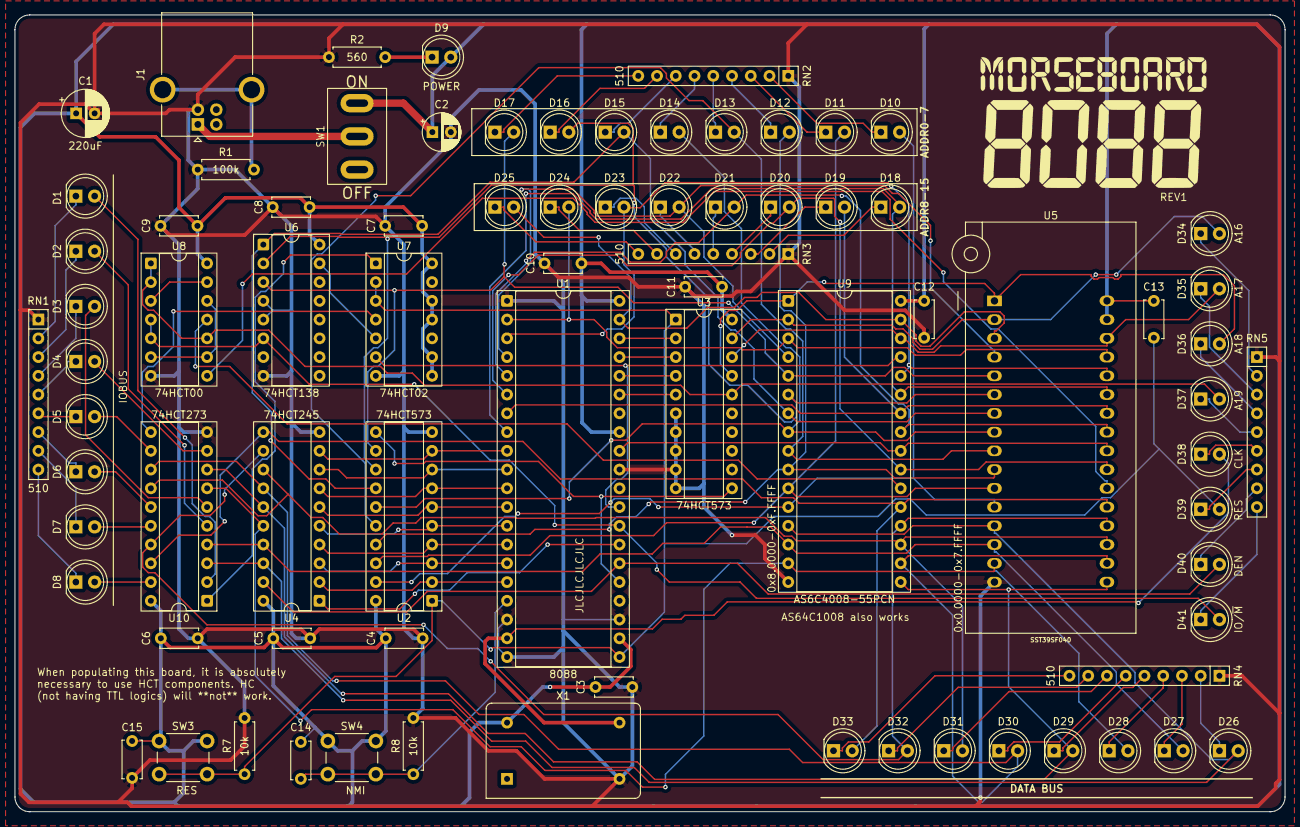
[picture p10: board mb88-testboard.kicad_pcb from above]

Board: 2 copper layers, 172.1 x 108.0 mm, 80 parts (0 on the bottom side), 109 nets.
