ifilot/morseboard-8088/(commit log)

2025-05-17 Adding source and revising PCB
    [morseboard-8088.kicad_pcb, output.kicad_sch]
2025-05-21 Revising testboard
    [mb88-testboard-B_Cu.gbr, mb88-testboard-B_Mask.gbr, mb88-testboard-B_Paste.gbr, mb88-testboard-B_Silkscreen.gbr, mb88-testboard-Edge_Cuts.gbr, mb88-testboard-F_Cu.gbr, mb88-testboard-F_Mask.gbr, mb88-testboard-F_Paste.gbr]
2025-05-21 Initial commit TL16C550
    [mb88-testboard.kicad_sch, morseboard-8088.kicad_sch]
2025-05-22 Further revising second 8088 SBC prototype
    [morseboard-8088.kicad_pcb, morseboard-8088.kicad_sch]
2025-05-23 Updating schematic and board
    [morseboard-8088.kicad_pcb, morseboard-8088.kicad_sch]
2025-05-24 Prerouting commit
    [morseboard-8088.dsn, morseboard-8088.kicad_pcb, morseboard-8088.kicad_sch]
2025-05-24 Protoype #1 of SBC
    [morseboard-8088-B_Cu.gbr, morseboard-8088-B_Mask.gbr, morseboard-8088-B_Paste.gbr, morseboard-8088-B_Silkscreen.gbr, morseboard-8088-Edge_Cuts.gbr, morseboard-8088-F_Cu.gbr, morseboard-8088-F_Mask.gbr, morseboard-8088-F_Paste.gbr]
2025-06-04 Tuning UART
    [morseboard-8088.kicad_sch]
2025-06-04 Interim commit
    [morseboard-8088.kicad_pcb, morseboard-8088.kicad_sch]
2025-06-05 Fixing bugs in PCB design
    [morseboard-8088.dsn, morseboard-8088.kicad_pcb]
2025-06-05 Creating new prototype
    [morseboard-8088-B_Cu.gbr, morseboard-8088-B_Mask.gbr, morseboard-8088-B_Paste.gbr, morseboard-8088-B_Silkscreen.gbr, morseboard-8088-Edge_Cuts.gbr, morseboard-8088-F_Cu.gbr, morseboard-8088-F_Mask.gbr, morseboard-8088-F_Paste.gbr]
2025-06-21 Fixing erroneous board layout
    [morseboard-8088-B_Cu.gbr, morseboard-8088-B_Mask.gbr, morseboard-8088-B_Paste.gbr, morseboard-8088-B_Silkscreen.gbr, morseboard-8088-Edge_Cuts.gbr, morseboard-8088-F_Cu.gbr, morseboard-8088-F_Mask.gbr, morseboard-8088-F_Paste.gbr]
2025-07-02 Adding enclosure
    [mb88-testboard-B_Cu.gbr, mb88-testboard-B_Mask.gbr, mb88-testboard-B_Paste.gbr, mb88-testboard-B_Silkscreen.gbr, mb88-testboard-Edge_Cuts.gbr, mb88-testboard-F_Cu.gbr, mb88-testboard-F_Mask.gbr, mb88-testboard-F_Paste.gbr]
2025-07-02 Further building menu and fixing minor mistakes in PCB
    [morseboard-8088-B_Cu.gbr, morseboard-8088-B_Mask.gbr, morseboard-8088-B_Paste.gbr, morseboard-8088-B_Silkscreen.gbr, morseboard-8088-Edge_Cuts.gbr, morseboard-8088-F_Cu.gbr, morseboard-8088-F_Mask.gbr, morseboard-8088-F_Paste.gbr]
2025-07-03 Fixing bug in MorseBoard ROM
    [rom.asm]
2025-07-04 Fixing bug and updating README
    [rom.asm]
2025-07-06 Polishing schematics
    [PLCC44.STEP, PLCC44_socket.stp, USB type-B female PCB.STEP, morseboard-8088.kicad_pcb, morseboard-8088.kicad_sch, switch.stp]
2025-07-13 Removing 8087 based board
    [morseboard-8088.kicad_sch]
